alexanderhay2020/499_pneumatic/design/apparatus.jpg

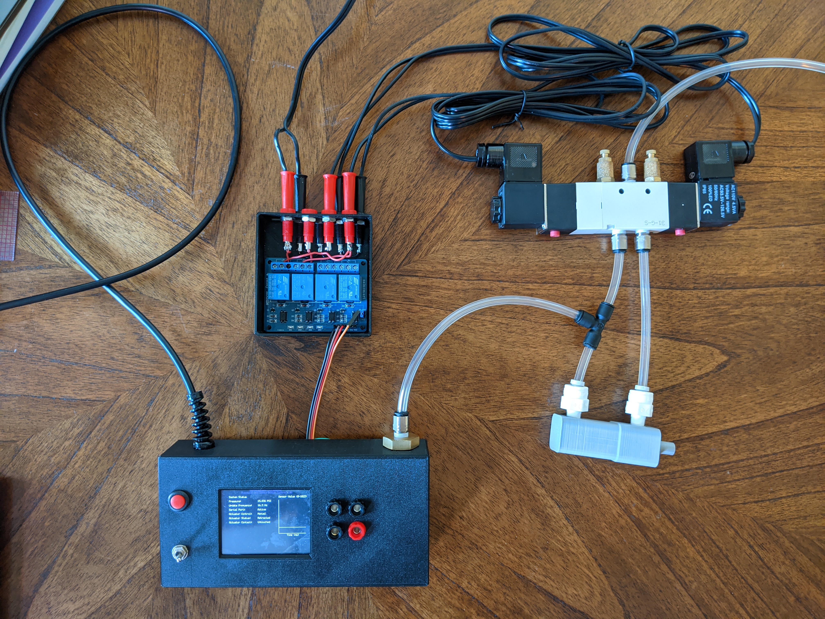
design/apparatus.jpg
