alexanderhay2020/499_pneumatic/design/schedule1.png

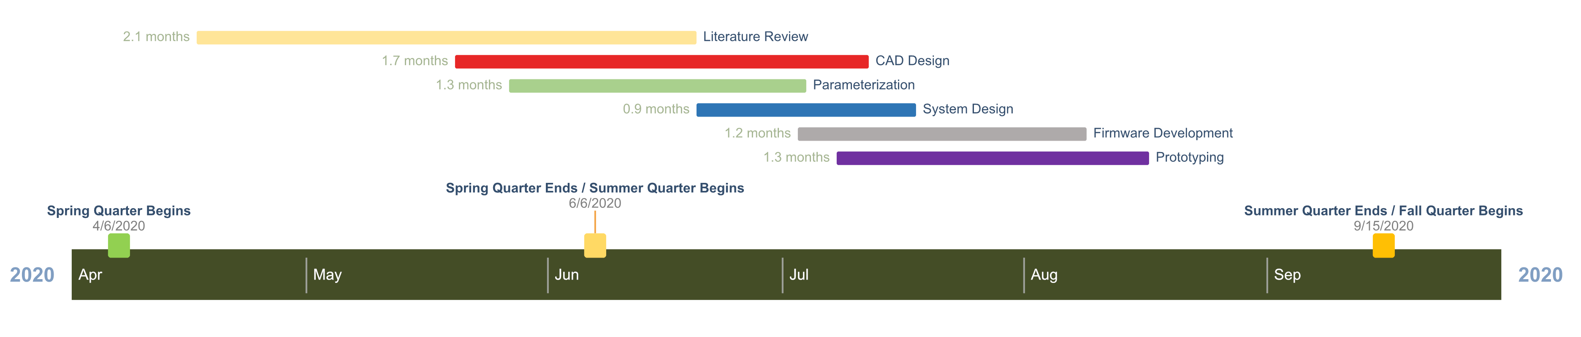
design/schedule1.png
