alexanderhay2020/499_pneumatic/design/schedule.png

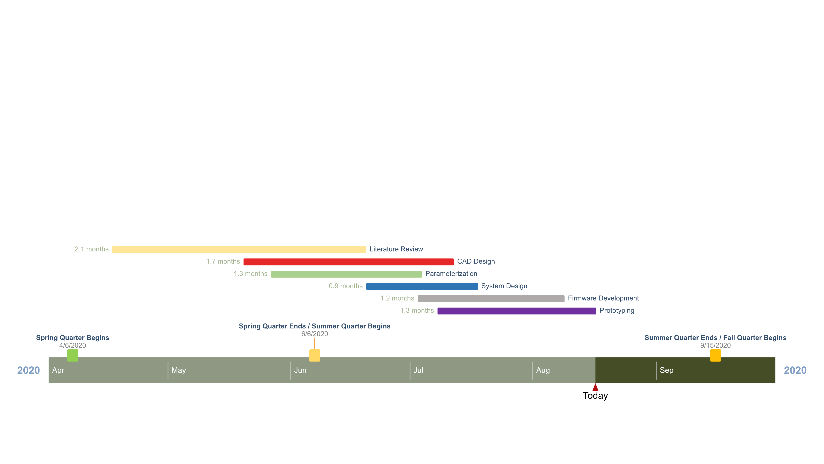
design/schedule.png
