alexanderhay2020/499_pneumatic/design/vid/fail_dump/demo_fail_01.gif

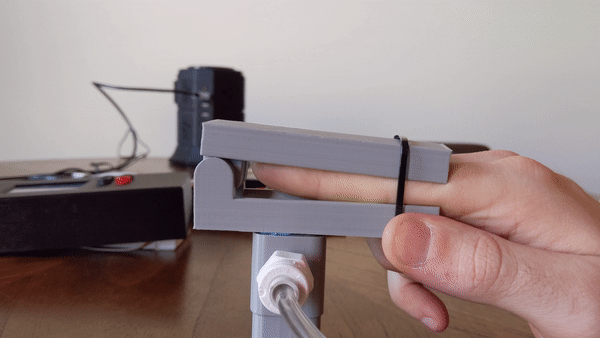
design/vid/fail_dump/demo_fail_01.gif
