alexanderhay2020/499_pneumatic/design/vid/fail_dump/demo_fail_03.gif

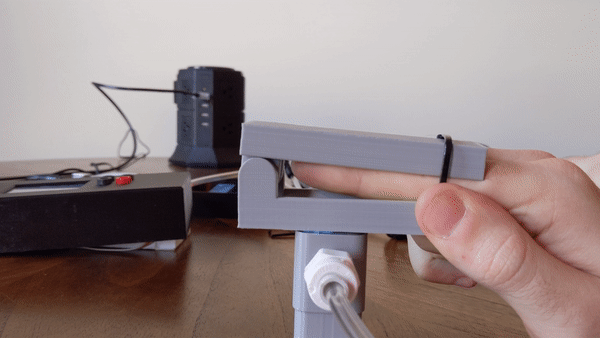
design/vid/fail_dump/demo_fail_03.gif
