alexanderhay2020/499_pneumatic/design/vid/demo_test.gif

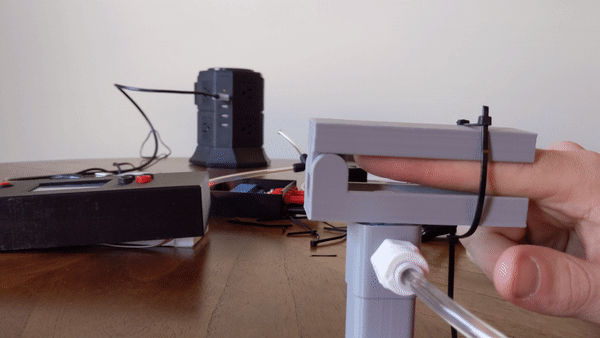
design/vid/demo_test.gif
