alexanderhay2020/499_pneumatic/firmware/src/ili9341.h

#ifndef ILI9341_H__
#define ILI9341_H__

// Color definitions
#define ILI9341_BLACK       0x0000  ///<   0,   0,   0
#define ILI9341_NAVY        0x000F  ///<   0,   0, 123
#define ILI9341_DARKGREEN   0x03E0  ///<   0, 125,   0
#define ILI9341_DARKCYAN    0x03EF  ///<   0, 125, 123
#define ILI9341_MAROON      0x7800  ///< 123,   0,   0
#define ILI9341_PURPLE      0x780F  ///< 123,   0, 123
#define ILI9341_OLIVE       0x7BE0  ///< 123, 125,   0
#define ILI9341_LIGHTGREY   0xC618  ///< 198, 195, 198
#define ILI9341_DARKGREY    0x7BEF  ///< 123, 125, 123
#define ILI9341_BLUE        0x001F  ///<   0,   0, 255
#define ILI9341_GREEN       0x07E0  ///<   0, 255,   0
#define ILI9341_CYAN        0x07FF  ///<   0, 255, 255
#define ILI9341_RED         0xF800  ///< 255,   0,   0
#define ILI9341_MAGENTA     0xF81F  ///< 255,   0, 255
#define ILI9341_YELLOW      0xFFE0  ///< 255, 255,   0
#define ILI9341_WHITE       0xFFFF  ///< 255, 255, 255
#define ILI9341_ORANGE      0xFD20  ///< 255, 165,   0
#define ILI9341_GREENYELLOW 0xAFE5  ///< 173, 255,  41
#define ILI9341_PINK        0xFC18  ///< 255, 130, 198

// lookup table for all of the ascii characters
static const char ASCII[96][5] = {
 {0x00, 0x00, 0x00, 0x00, 0x00} // 20  (space)
,{0x00, 0x00, 0x5f, 0x00, 0x00} // 21 !
,{0x00, 0x07, 0x00, 0x07, 0x00} // 22 "
,{0x14, 0x7f, 0x14, 0x7f, 0x14} // 23 #
,{0x24, 0x2a, 0x7f, 0x2a, 0x12} // 24 $
,{0x23, 0x13, 0x08, 0x64, 0x62} // 25 %
,{0x36, 0x49, 0x55, 0x22, 0x50} // 26 &
,{0x00, 0x05, 0x03, 0x00, 0x00} // 27 '
,{0x00, 0x1c, 0x22, 0x41, 0x00} // 28 (
,{0x00, 0x41, 0x22, 0x1c, 0x00} // 29 )
,{0x14, 0x08, 0x3e, 0x08, 0x14} // 2a *
,{0x08, 0x08, 0x3e, 0x08, 0x08} // 2b +
,{0x00, 0x50, 0x30, 0x00, 0x00} // 2c ,
,{0x08, 0x08, 0x08, 0x08, 0x08} // 2d -
,{0x00, 0x60, 0x60, 0x00, 0x00} // 2e .
,{0x20, 0x10, 0x08, 0x04, 0x02} // 2f /
,{0x3e, 0x51, 0x49, 0x45, 0x3e} // 30 0
,{0x00, 0x42, 0x7f, 0x40, 0x00} // 31 1
,{0x42, 0x61, 0x51, 0x49, 0x46} // 32 2
,{0x21, 0x41, 0x45, 0x4b, 0x31} // 33 3
,{0x18, 0x14, 0x12, 0x7f, 0x10} // 34 4
,{0x27, 0x45, 0x45, 0x45, 0x39} // 35 5
,{0x3c, 0x4a, 0x49, 0x49, 0x30} // 36 6
,{0x01, 0x71, 0x09, 0x05, 0x03} // 37 7
,{0x36, 0x49, 0x49, 0x49, 0x36} // 38 8
,{0x06, 0x49, 0x49, 0x29, 0x1e} // 39 9
,{0x00, 0x36, 0x36, 0x00, 0x00} // 3a :
,{0x00, 0x56, 0x36, 0x00, 0x00} // 3b ;
,{0x08, 0x14, 0x22, 0x41, 0x00} // 3c <
,{0x14, 0x14, 0x14, 0x14, 0x14} // 3d =
,{0x00, 0x41, 0x22, 0x14, 0x08} // 3e >
,{0x02, 0x01, 0x51, 0x09, 0x06} // 3f ?
,{0x32, 0x49, 0x79, 0x41, 0x3e} // 40 @
,{0x7e, 0x11, 0x11, 0x11, 0x7e} // 41 A
,{0x7f, 0x49, 0x49, 0x49, 0x36} // 42 B
,{0x3e, 0x41, 0x41, 0x41, 0x22} // 43 C
,{0x7f, 0x41, 0x41, 0x22, 0x1c} // 44 D
,{0x7f, 0x49, 0x49, 0x49, 0x41} // 45 E
,{0x7f, 0x09, 0x09, 0x09, 0x01} // 46 F
,{0x3e, 0x41, 0x49, 0x49, 0x7a} // 47 G
,{0x7f, 0x08, 0x08, 0x08, 0x7f} // 48 H
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
}; // end char ASCII[96][5]

// ILI9341 registers
#define ILI9341_TFTWIDTH   320      ///< ILI9341 max TFT width
#define ILI9341_TFTHEIGHT  240      ///< ILI9341 max TFT height

#define ILI9341_NOP        0x00     ///< No-op register
#define ILI9341_SWRESET    0x01     ///< Software reset register
#define ILI9341_RDDID      0x04     ///< Read display identification information
#define ILI9341_RDDST      0x09     ///< Read Display Status

#define ILI9341_SLPIN      0x10     ///< Enter Sleep Mode
#define ILI9341_SLPOUT     0x11     ///< Sleep Out
#define ILI9341_PTLON      0x12     ///< Partial Mode ON
#define ILI9341_NORON      0x13     ///< Normal Display Mode ON

#define ILI9341_RDMODE     0x0A     ///< Read Display Power Mode
#define ILI9341_RDMADCTL   0x0B     ///< Read Display MADCTL
#define ILI9341_RDPIXFMT   0x0C     ///< Read Display Pixel Format
#define ILI9341_RDIMGFMT   0x0D     ///< Read Display Image Format
#define ILI9341_RDSELFDIAG 0x0F     ///< Read Display Self-Diagnostic Result

#define ILI9341_INVOFF     0x20     ///< Display Inversion OFF
#define ILI9341_INVON      0x21     ///< Display Inversion ON
#define ILI9341_GAMMASET   0x26     ///< Gamma Set
#define ILI9341_DISPOFF    0x28     ///< Display OFF
#define ILI9341_DISPON     0x29     ///< Display ON

#define ILI9341_CASET      0x2A     ///< Column Address Set
#define ILI9341_PASET      0x2B     ///< Page Address Set
#define ILI9341_RAMWR      0x2C     ///< Memory Write
#define ILI9341_RAMRD      0x2E     ///< Memory Read

#define ILI9341_PTLAR      0x30     ///< Partial Area
#define ILI9341_MADCTL     0x36     ///< Memory Access Control
#define ILI9341_VSCRSADD   0x37     ///< Vertical Scrolling Start Address
#define ILI9341_PIXFMT     0x3A     ///< COLMOD: Pixel Format Set

#define ILI9341_FRMCTR1    0xB1     ///< Frame Rate Control (In Normal Mode/Full Colors)
#define ILI9341_FRMCTR2    0xB2     ///< Frame Rate Control (In Idle Mode/8 colors)
#define ILI9341_FRMCTR3    0xB3     ///< Frame Rate control (In Partial Mode/Full Colors)
#define ILI9341_INVCTR     0xB4     ///< Display Inversion Control
#define ILI9341_DFUNCTR    0xB6     ///< Display Function Control

#define ILI9341_PWCTR1     0xC0     ///< Power Control 1
#define ILI9341_PWCTR2     0xC1     ///< Power Control 2
#define ILI9341_PWCTR3     0xC2     ///< Power Control 3
#define ILI9341_PWCTR4     0xC3     ///< Power Control 4
#define ILI9341_PWCTR5     0xC4     ///< Power Control 5
#define ILI9341_VMCTR1     0xC5     ///< VCOM Control 1
#define ILI9341_VMCTR2     0xC7     ///< VCOM Control 2

#define ILI9341_RDID1      0xDA     ///< Read ID 1
#define ILI9341_RDID2      0xDB     ///< Read ID 2
#define ILI9341_RDID3      0xDC     ///< Read ID 3
#define ILI9341_RDID4      0xDD     ///< Read ID 4

#define ILI9341_GMCTRP1    0xE0     ///< Positive Gamma Correction
#define ILI9341_GMCTRN1    0xE1     ///< Negative Gamma Correction
//#define ILI9341_PWCTR6     0xFC

#define MADCTL_MY  0x80  ///< Bottom to top
#define MADCTL_MX  0x40  ///< Right to left
#define MADCTL_MV  0x20  ///< Reverse Mode
#define MADCTL_ML  0x10  ///< LCD refresh Bottom to top
#define MADCTL_RGB 0x00  ///< Red-Green-Blue pixel order
#define MADCTL_BGR 0x08  ///< Blue-Green-Red pixel order
#define MADCTL_MH  0x04  ///< LCD refresh right to left

// spi pins
#define CS LATBbits.LATB7
#define DC LATBbits.LATB15

// functions
void LCD_init();
void SPI1_init();
unsigned char spi_io(unsigned char o);
void LCD_command(unsigned char com) ;
void LCD_data(unsigned char dat);
void LCD_data16(unsigned short dat);
void LCD_setAddr(unsigned short x, unsigned short y, unsigned short w, unsigned short h);
void LCD_drawPixel(unsigned short x, unsigned short y, unsigned short color);
void LCD_clearScreen(unsigned short color);
void print_char(unsigned short x, unsigned short y, char ch);
void print_header(unsigned short x, unsigned short y, char ch);
void clear_space(unsigned short x, unsigned y, unsigned short end);
void write_screen(int x, int y, char *msg);

#endif
