alexanderhay2020/499_pneumatic/(commit log)

2020-10-24 PIC reads toggle switch input
2020-10-30 UART tx working, via nscope
2020-10-30 modularized tx/rx pins, no longer hard coded
    [init.c, uart.c, uart.h]
2020-11-02 relay pins respond to toggle switch
2020-11-06 printf to write over serial
2020-11-20 ctmu works. adc is now manually scanned. ctmu still needs debounced
2020-11-20 added debounce delay for cap cahrging. cap touch responds well. may need to be calibrated
2020-12-11 removed I2C finder
